florisvanvugt/taparduino/arduino/fsr_tone_disc_seq/fsr_tone_disc_seq.ino

// -*- Mode:c -*-
// The above incantation tells emacs to do C style syntax highlighting

/* Use FSR to create a sound on an audio jack from a PWM pin

Connect the audio jack to digital pin 9 through a 1kOhm resistor

Ensure that the Arduino (or microcontroller) used has a PWM pin for this arrangement.

Connect one end of FSR to 5V, the other end to Analog 0.
Then connect one end of a 10K resistor from Analog 0 to ground

*/

//////////////////////////////////// load libraries
#include <avr/pgmspace.h>
#include <avr/sleep.h>

////////////////////////////////////  set variables 
int fsrAnalogPin = 0; // FSR is connected to analog 0
int fsrReading;      // the analog reading from the FSR resistor divider
int threshold = 20; // the FSR threshold necessary to make a sound (ON)
int low_thresh = 10; // where the FSR reading must go to to be OFF
int time_thresh = 40; // set a time threshold for how long to wait until another sound can be made
int offset_thresh = 40; // set a time threshold for how long to wait after depression (prevent double taps)
unsigned long time_tol = 0; // preset the exact time from which it is ok to make another sound
unsigned long timeStamp=0; // timestamp for Arduino
unsigned long prevt=-1; // the previous time value to ensure sample rate of 1000Hz
int cur_on = 0; // say if the FSR is "on" or "off"

// variables for discrete data
unsigned long cur_onset = 0; // preset current onset time
unsigned long cur_offset = 0; // preset current offset time
int max_force = 0; // preset maximum FSR reading

// variables for tone condition
//int tone_freq = 1046.5; // defines the frequency (i.e., pitch) of the tone (in Hz)
//int tone_dur = 20; // defines the duration of the tone
unsigned long tone_tol=0; // presets the tone offset time

// variables for tone sequences
int all_tones[30] = {220, 220, 233.08, 261.63, 261.63, 233.08, 220, 196, 174.61, 174.61, 196, 220, 220, 196, 196, 220, 220, 233.08, 261.63, 261.63, 233.08, 220, 196, 174.61, 174.61, 196, 220, 196, 174.61, 174.61  };
int all_durs[30] = {200, 200, 200, 200, 200, 200, 200, 200, 200, 200, 200, 200, 400, 100, 400, 200, 200, 200, 200, 200, 200, 200, 200, 200, 200, 200, 200, 400, 100, 400  };
int all_delays[30] = {0, 0, 0, 75, 50, 50, 100, 50, 50, 50, 50, 50, 50, 25, 100, 0, 0, 0, 0, 0, 0, 0, 0, 0, 0, 0, 0, 0, 0, 0 };
int num_sounds = sizeof(all_tones)/sizeof(all_tones[0])-1;
//int all_intense[30] = { 10, 1, 5, 6, 7, 2, 3, 4, 9, 8, 7, 6, 5, 4, 3, 10, 1, 5, 6, 7, 2, 3, 4, 9, 8, 7, 6, 5, 10, 10 };
//int all_timbre[15] = { 1, 1, 1, 1, 3, 3, 3, 3, 2, 2, 2, 2, 2, 2, 2 };

// get first tone sequence value
int tone_freq = all_tones[0]; // defines the frequency (i.e., pitch) of the tone (in Hz)
int tone_dur = all_durs[0]; // defines the duration of the tone
int cur_del = all_delays[0]; // defines delays
int cur_pos = 0; // preset start position
//int intense = all_intense[0]; // defines the duration of the tone
//int cur_tim = all_timbre[1]; // defines timbre


/////////////////////////////// Set up lookup table for waveform generation
/*
A SQUARE WAVE lookup table. You can generate this using the example Python code here below:
sqwav = [ '0xff' for _ in range(256/2) ] + [ '0x00' for _ in range(256/2) ]
print ",".join(sqwav)
*/

static const uint8_t  sineTable[] PROGMEM =
{
0xff,0xff,0xff,0xff,0xff,0xff,0xff,0xff,
0xff,0xff,0xff,0xff,0xff,0xff,0xff,0xff,
0xff,0xff,0xff,0xff,0xff,0xff,0xff,0xff,
0xff,0xff,0xff,0xff,0xff,0xff,0xff,0xff,
0xff,0xff,0xff,0xff,0xff,0xff,0xff,0xff,
0xff,0xff,0xff,0xff,0xff,0xff,0xff,0xff,
0xff,0xff,0xff,0xff,0xff,0xff,0xff,0xff,
0xff,0xff,0xff,0xff,0xff,0xff,0xff,0xff,
0xff,0xff,0xff,0xff,0xff,0xff,0xff,0xff,
0xff,0xff,0xff,0xff,0xff,0xff,0xff,0xff,
0xff,0xff,0xff,0xff,0xff,0xff,0xff,0xff,
0xff,0xff,0xff,0xff,0xff,0xff,0xff,0xff,
0xff,0xff,0xff,0xff,0xff,0xff,0xff,0xff,
0xff,0xff,0xff,0xff,0xff,0xff,0xff,0xff,
0xff,0xff,0xff,0xff,0xff,0xff,0xff,0xff,
0xff,0xff,0xff,0xff,0xff,0xff,0xff,0xff,
0x00,0x00,0x00,0x00,0x00,0x00,0x00,0x00,
0x00,0x00,0x00,0x00,0x00,0x00,0x00,0x00,
0x00,0x00,0x00,0x00,0x00,0x00,0x00,0x00,
0x00,0x00,0x00,0x00,0x00,0x00,0x00,0x00,
0x00,0x00,0x00,0x00,0x00,0x00,0x00,0x00,
0x00,0x00,0x00,0x00,0x00,0x00,0x00,0x00,
0x00,0x00,0x00,0x00,0x00,0x00,0x00,0x00,
0x00,0x00,0x00,0x00,0x00,0x00,0x00,0x00,
0x00,0x00,0x00,0x00,0x00,0x00,0x00,0x00,
0x00,0x00,0x00,0x00,0x00,0x00,0x00,0x00,
0x00,0x00,0x00,0x00,0x00,0x00,0x00,0x00,
0x00,0x00,0x00,0x00,0x00,0x00,0x00,0x00,
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
0xc0, 0xc1, 0xc2, 0xc3, 0xc4, 0xc5, 0xc6, 0xc7,
0xc8, 0xc9, 0xca, 0xcb, 0xcc, 0xcd, 0xce, 0xcf,
0xd0, 0xd1, 0xd2, 0xd3, 0xd4, 0xd5, 0xd6, 0xd7,
0xd8, 0xd9, 0xda, 0xdb, 0xdc, 0xdd, 0xde, 0xdf,
0xe0, 0xe1, 0xe2, 0xe3, 0xe4, 0xe5, 0xe6, 0xe7,
0xe8, 0xe9, 0xea, 0xeb, 0xec, 0xed, 0xee, 0xef,
0xf0, 0xf1, 0xf2, 0xf3, 0xf4, 0xf5, 0xf6, 0xf7,
0xf8, 0xf9, 0xfa, 0xfb, 0xfc, 0xfd, 0xfe, 0xff
};

*/

////////////////////////////////////  set PWM variables and functions
// PWM output (OCR1A)
int pwmPin = 9;

// 16 bit accumulator
uint16_t phaseAccumulator = 0;
// 16 bit delta
uint16_t phaseIncrement = 0;
// DDS resolution
const uint32_t resolution =  68719;
// wavetable lookup index(upper 8 bits of the accumulator)
uint8_t index = 0;

// TIMER1 will overflow at a 62.5KHz(Sampling frequency).
// Updates the OCR1A value and the accumulator.
// Computes the next sample to be sent to the PWM.
ISR(TIMER1_OVF_vect)
{
  static uint8_t osc = 0;

  // Send oscillator output to PWM
  OCR1A = osc;

  // Update accumulator
  phaseAccumulator += phaseIncrement;
  index = phaseAccumulator >> 8;

  // Read oscillator value for next interrupt
  osc = pgm_read_byte( &sineTable[index] );

}

// Configures TIMER1 to fast PWM non inverted mode.
// Prescaler set to 1, which means that timer overflows
// every 16MHz/256 = 62.5KHz
void initPWM(void)
{
  // Set PORTB1 pin as output
  pinMode(pwmPin, OUTPUT);

  // 8-bit Fast PWM - non inverted PWM
  TCCR1A= _BV(COM1A1) | _BV(WGM10);

  // Start timer without prescaler
  TCCR1B = _BV(CS10) | _BV(WGM12);

  // Enable overflow interrupt for OCR1A
  TIMSK1 = _BV(TOIE1);

}

// Translates the desired output frequency to a phase
// increment to be used with the phase accumulator.
// The 16 bit shift is required to remove the  2^16
// scale factor of the resolution.
void setFrequency( uint16_t frequency )
{
  uint64_t phaseIncr64 =  resolution * frequency;
  phaseIncrement = phaseIncr64 >> 16;
}

// The duration of one metronome tick (in microsec)
const unsigned long TICKDURATION = tone_dur*1000;   // duration of ticks (legacy code)

// function to turn tick on
void tickOn(){
  setFrequency(tone_freq);
}

// function to turn sound off
void tickOff() {
  setFrequency( .05 ); // so that you practically don't hear anything (well below perceptual limit of humans)
}


//////////////////////////////////// SETUP
void setup() {
  Serial.begin(9600); // slow speed debugging
  //Serial.begin(1152000); // high speed debugging
  //Serial.begin(1555200); // good speed for processing (must match python code for reading!)
  
  // Initialise fast PWM
  initPWM();

  // Enable sleep mode
  set_sleep_mode(SLEEP_MODE_IDLE);

  // Set phase increment according to
  // desired OFF frequency
  tickOff();

  // Enable global interrupts
  sei();
 
}

//////////////////////////////////// LOOP
void loop(void) {
  getInfos(); // read info 
  
  if (fsrReading > threshold){
    cur_onset = timeStamp;
    time_tol = timeStamp+time_thresh;
    cur_on  = 1;
    
    while (timeStamp < time_tol) { // wait for delay time
      //if (fsrReading > max_force) max_force = fsrReading;
      getInfos(); // read info    
    }

    // play the tone
    tickOn(); // change PWM output to tone frequency
    tone_tol = timeStamp+tone_dur; // set tone off time        
    getInfos(); // read info
    
    // now let's stop it from playing again until after the time threshold and the FSR reading returns to zero    
    while (fsrReading > low_thresh) {
      getInfos(); // read info
    }
    
    cur_offset = timeStamp; // get offset time   
    collectData(); // send data   
    time_tol = timeStamp+offset_thresh; // set time until next tap can occur
    
    // now let's stop it from playing again until after the time threshold and the FSR reading returns to zero    
    while ((timeStamp < time_tol) || (fsrReading > low_thresh)) {      
      getInfos(); // read info      
   }
   
   // reset our variables
   if (cur_pos == num_sounds) {
     cur_pos = 0; 
   }
   else {
     cur_pos = cur_pos+1;      
   }
    
   tone_freq = all_tones[cur_pos]; // defines the frequency (i.e., pitch) of the tone (in Hz)
   tone_dur = all_durs[cur_pos]; // defines the duration of the tone
   cur_del = all_delays[cur_pos]; // defines delays
   
  }
  
  max_force = fsrReading;
     
}

//////////////////////////////////// FUNCTIONS
// Send data to serial port
void collectData() { 
      
  if (prevt==-1 | timeStamp!=prevt) { 
    // only send if the time has changed, that is, 
    // force the data transfer to maximum of 1000Hz.
    // Using higher sample rates can result in buffer
    // overflows and missed packets

    // Send data to the serial port (for degugging in Arduino serial manager)
    //Serial.print("Onset time = ");
    //Serial.print(cur_onset);
    //Serial.print(" Offset time = ");
    //Serial.print(cur_offset);
    //Serial.print(" Maximum force = ");
    //Serial.print(max_force);    
    //Serial.print("\n");
    
    // Send data to the serial port
    Serial.print("B"); // signal packet start (hardcoded)
    sendBinary(cur_onset); // send onset time
    sendBinary(cur_offset); // send offset time
    sendBinary(max_force); // send max FSR reading
    Serial.print("E"); // signal packet end (hardcoded)
    prevt=timeStamp; // send previous time marker
  }    
}

// get FSR and timing info, and turn off the sound at end of tone duration
void getInfos() {
  fsrReading = analogRead(fsrAnalogPin); // read FSR
  timeStamp = millis(); // get time (in milliseconds)       
  if (timeStamp>=tone_tol) {
    tickOff(); // turn sound off
    phaseAccumulator = 0; // reset phase
  }
  if (fsrReading > max_force) max_force = fsrReading;
  if ((cur_on==1) && (fsrReading <= low_thresh)) {
    cur_offset = timeStamp; // get offset time   
    collectData(); // send data   
    cur_on = 0;
  }  
}

// Send data in binary to increase speed and reduce buffer overflow
void sendBinary(int value) 
// Send a binary value directly (without conversion to string)
// based on http://my.safaribooksonline.com/book/hobbies/9781449399368/serial-communications/sending_binary_data_from_arduino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
{
  Serial.write(lowByte(value));
  Serial.write(highByte(value));
}
