florisvanvugt/taparduino/gui/capture-gui.py

#
#
#
# This is a graphical user interface that is used to conveniently capture data from arduino, 
# through USB, to a PC or Mac computer, and dump it to a text file for future analysis.
#
#
#
#





import threading

import os.path 


import Tkinter 
import tkFileDialog
from Tkinter import *
from tkFileDialog import asksaveasfilename

import tkMessageBox


from FileDialog import LoadFileDialog, SaveFileDialog

import platform
import os


import sys

try:
    import serial
except:
    msg = "An error occurred while importing the pySerial module.\n\nGo to https://pypi.python.org/pypi/pyserial to install the module,\nor refer to our manual for help.\n\nThe program will now quit."
    print msg
    tkMessageBox.showinfo("Error importing pySerial", msg)
    sys.exit(-1)


import time
baudrate_discrete   = 9600    # for the discrete data setting (load the corresponding Arduino script)
baudrate_continuous = 115200  # for the continuous data setting (load the corresponding Arduino script)






## The maximum number of lines to remain in the GUI text area
## (this prevents errors due to keeping all lines in memory)
MAX_LINES = 42



class Reporter:

    # This class will receive the data and display it in the text field in the GUI.

    def __init__(self):
        self.thread = None
        self.lock = False
    
    def report(self,message):
        if not self.lock:
            self.lock = True
            #print "Reporting",message
            self.text.insert(Tkinter.END,message)

            #numlines = int(self.text.index('end - 1 line').split('.')[0])
            #numlines = int(self.text.index('end').split('.')[0]) - 1
            numlines = self.text.get("1.0", Tkinter.END).count("\n")
            #print numlines
            #log['state'] = 'normal'
            if numlines>MAX_LINES:
                #print "Number of lines: %i"%numlines
                #self.text.delete(1.0, "%i.0"%(MAX_LINES-numlines+1))
                self.text.delete("1.0", "2.0")

            self.text.see(Tkinter.END)
            self.lock= False

    def settextreceiver(self,textreceiver):
        self.text = textreceiver

    def startNew(self):
        # Clear the text field
        self.text.delete(1.0, END)

    def updateButtons(self):
        # This enables/disables buttons depending on whether we are running a capture at the moment or not
        if keepGoingB.get():
            #self.previewB.configure(state=NORMAL,background="yellow")
            self.stopB.configure   (state=NORMAL,  background="red")
            self.captureB.configure(state=DISABLED,background="gray")

            self.discR.config(state=DISABLED)
            self.contR.config(state=DISABLED)

        else:

            self.discR.config(state=NORMAL)
            self.contR.config(state=NORMAL)

            # Update which buttons are enabled or not
            global packetI

            continuous = packetI.get()!=1
            if continuous:
                buttonstate = NORMAL
            else:
                buttonstate = DISABLED
            # Whether we are in continuous data mode

            self.fastR.config(  state=buttonstate)
            self.mediumR.config(state=buttonstate)
            self.slowR.config(  state=buttonstate)

            self.stopB.configure   (state=DISABLED,background="gray")
            if len(fileS.get())>0:
                self.captureB.configure(state=NORMAL,  background="darkgreen")
            else:
                reporter.captureB.configure( state=DISABLED, background="gray" )






    def determine_dump_interval(self):
        global packetI # tells us what kind of data package we expect
        global displayI # tells us what kind of display refresh rate

        packet_type = packetI.get()
        if packet_type==1:
            # discrete: one packet per tap
            self.report_dump_interval = 1
        if packet_type==2:
            
            refreshrate = displayI.get()
            
            # This controls what fraction of packages is displayed: if set to 100, it will show 1 package in 100.
            refreshrates = {1: 10,
                            2: 100,
                            3: 1000}
            self.report_dump_interval = refreshrates[refreshrate]
            







def interpret_output_discrete(r):
    # Interpret the raw (binary) output that we got from Arduino.

    #Packet
    #|---------+---+---------+----------+-------------+---|
    #| Byte    | 1 | 2,3     | 4,5      | 6,7         | 8 |
    #| Content | B | [onset] | [offset] | [max force] | E |
    #|---------+---+---------+----------+-------------+---|
    
    #Where [t] = N for oNset, F for oFfset
    #and [time] is the timestamp (in msec)


    # Here we interpret the packet that we received from Arduino.
    # Note that the first element of the packet (B in our case) has been omitted here.
    tap_onset  = ord(r[0])+256*ord(r[1])
    tap_offset = ord(r[2])+256*ord(r[3])
    maxforce   = ord(r[4])+256*ord(r[5])
    
    # Make a formatted output
    output = "%i %i %i"%(tap_onset,tap_offset,maxforce)

    return output



def interpret_output_continuous(r):
    # Interpret the raw (binary) output that we got from Arduino.

    # Packet
    #|---------+---+-------------+---------------+---|
    #| Byte    | 1 | 2,3         | 4,5           | 6 |
    #| Content | B | [timestamp] | [fsr-reading] | E |
    #|---------+---+-------------+---------------+---|
    #Here [timestamp] is the timestamp (in msec)
    #and [fsr-reading] is the FSR voltage (in arduino's arbitrary units).


    # Here we interpret the packet that we received from Arduino.
    # Note that the first element of the packet (B in our case) has been omitted here.
    timestamp   = ord(r[0])+256*ord(r[1])
    fsr_reading = ord(r[2])+256*ord(r[3])
    
    # Make a formatted output
    output = "%i %i"%(timestamp,fsr_reading)

    return output












def askSaveFile():
    # Asks where to save the file

    global fileS
    global reporter

    filename = asksaveasfilename(parent=root,
                                 defaultextension=".txt",
                                 initialfile=fileS.get(),
                                 filetypes=[("text files","*.txt"),
                                            ("all files","*")])

    if filename:
        fileS.set(filename)
        reporter.updateButtons()
        


def stopCapture():
    global keepGoingB
    global reporter

    keepGoingB.set(False)
    reporter.report("Capture stopped.\n\n")
    reporter.thread=None
    reporter.updateButtons()

    reporter.comm.close()



def runCapture():

    # This is called from the doCapture function

    print ("Starting capture")
        
    # Start up the serial communication
    commport = usbS.get()
    packet_type = packetI.get()
    if (packet_type==1):
        baudrate = baudrate_discrete
    else:
        baudrate = baudrate_continuous

    try:
        comm = serial.Serial(commport, baudrate, timeout=0.25)
    except:
        reporter.report("Cannot open USB port %s. Is the device connected?\n"%commport)
        stopCapture()
        return -1

    reporter.comm = comm

    filename = fileS.get() # get the filename we are supposed to output to

    if len(filename)==0:
        reporter.report("Please select an output file.\n")
        stopCapture()
        return -1

       
    if os.path.isfile(filename):
        reporter.report("Output file previously existed! If we continue, we will overwrite all data in it.\n")
        if not tkMessageBox.askyesno('Confirm overwriting data file', 'The data file you have selected for output already exists.\nIf we proceed, all data currently in the file will be erased.\n\nAre you sure that you want to continue?'):
            reporter.report("Capture aborted because the user does not want to overwrite the data file.\n")
            stopCapture()
            return -1
        

    dumpfile = open(filename,'w')

    do_continue=True
    keepGoingB.set(do_continue)
    reporter.report("Starting capture (%s)\n"%filename)
    reporter.updateButtons()


    reporter.report("")
    reporter.report(output_header+"\n")
    dumpfile.write(output_header+"\n")

    i=0
    while do_continue:

        # Ok, let's read one byte
        r = comm.read(1)

        if r=="B": # This could be the beginning of a packet from arduino

            avail=0 # how many bytes are available
            while avail<PACKET_LENGTH-1: # read to fill up the packet
                avail=comm.inWaiting()

            # all right, now we can read
            r = comm.read(PACKET_LENGTH-1) # read the whole packet straight away

            # Now continue to work with this
            if len(r)==(PACKET_LENGTH-1) and r[-1]=="E": # if we have the correct ending also

                output = interpret_output(r)
                dumpfile.write(output+"\n")
                dumpfile.flush()

                # Occasionally give a bleep so the user knows
                # we're still working
                i+=1
                if i>=reporter.report_dump_interval:
                    reporter.report(output+"\n")
                    i=0

            else:
                if len(r)>0:
                    reporter.report("rejected")

        do_continue = keepGoingB.get()


    # Update which button is enabled etc.
    reporter.updateButtons()






def doCapture():

    # This is when the "capture" button is pressed
    # First, we set everything up and then we set the actual capture in motion

    global reporter

    if reporter.thread!=None:
        reporter.report("Already running!\n")
        return -1


    # The expected packet length

    global PACKET_LENGTH
    global interpret_output
    global output_header
    packet_type = packetI.get()
    if packet_type==1:
        # discrete: one packet per tap
        PACKET_LENGTH = 8
        interpret_output = interpret_output_discrete
        output_header = "onset offset maxforce"


    if packet_type==2:
        # continuous: simply forwarding the trace of the FSR sensor
        PACKET_LENGTH = 6
        interpret_output = interpret_output_continuous
        output_header = "timestamp force_reading"



    reporter.startNew()
    reporter.determine_dump_interval()
    reporter.thread = threading.Thread(target=runCapture)
    reporter.thread.start()



    







def build_gui():


    # Making a bunch of variables that I will access from anywhere in this GUI
    global usbS       # the current setting for the serial port
    global fileS      # the current setting for the file name
    global packetI    # the type of data that we will receive from arduino
    global displayI   # how often the display should update
    global keepGoingB # keep track of whether we're still capturing
    global root

    root =Tk()
    root.title('Tap-Arduino Capture GUI (Ben Schultz & Floris van Vugt)')

    usbS       = StringVar()
    fileS      = StringVar()
    packetI    = IntVar()
    displayI   = IntVar()
    keepGoingB = BooleanVar()

    packetI.set(1)
    displayI.set(2)

    if len(sys.argv)>1:
        usbS.set(sys.argv[1])
    else:
        if platform.system()=="Windows":
            usbS.set("COM<NUMBER>")
        elif os.name=="posix":
            usbS.set("/dev/ttyACM0")
        else:
            usbS.set("<ENTER SERIAL PORT HERE>")
    if len(sys.argv)>2:
        fileS.set(sys.argv[2])
    else:
        fileS.set("")
    keepGoingB.set(False)


    global reporter
    reporter = Reporter()


    usbF = Frame(root)
    Label (usbF,text='serial port').pack(side=LEFT,padx=10,pady=10)
    usbEntry = Entry (usbF,width=30,textvariable=usbS)
    #usbEntry = Frame (usbF,background="red")
    usbEntry.pack(expand=True,side=LEFT,padx=10,pady=10,fill=BOTH)
    #Label (usbEntry,text="this will expand?").pack(side=LEFT,padx=10,pady=10,fill=BOTH)
    #usbEntry.pack(side=LEFT,padx=10,pady=10,fill=BOTH)
    usbF.pack(side=TOP,padx=10,fill=X)



    fileF = Frame(root)
    Label (fileF,text='save to file').pack(side=LEFT,padx=10)
    fileEntry = Entry (fileF,width=30,textvariable=fileS)
    fileEntry.pack(side=LEFT,expand=True,padx=10,pady=10,fill=X)
    fileB = Button(fileF,text="select",command=askSaveFile)
    fileB.pack(side=RIGHT,padx=10,pady=10)
    fileF.pack(padx=10,pady=0,fill=X)
    



    packetF = Frame(root)
    Label (packetF,text='data type').pack(side=LEFT,padx=10)
    discR = Radiobutton(packetF, text="discrete",   variable=packetI, value=1, command=reporter.updateButtons)
    contR = Radiobutton(packetF, text="continuous", variable=packetI, value=2, command=reporter.updateButtons)
    discR.pack(side=LEFT,padx=10,pady=10)
    contR.pack(side=LEFT,padx=10,pady=10)
    packetF.pack(padx=10,pady=0,fill=X)




    updateF = Frame(root)
    Label (updateF,text='display update').pack(side=LEFT,padx=10)
    fastR    = Radiobutton(updateF, text="fast",   variable=displayI, value=1, command=reporter.determine_dump_interval)
    mediumR  = Radiobutton(updateF, text="medium", variable=displayI, value=2, command=reporter.determine_dump_interval)
    slowR    = Radiobutton(updateF, text="slow",   variable=displayI, value=3, command=reporter.determine_dump_interval)
    fastR.pack(side=LEFT,padx=10,pady=10)
    mediumR.pack(side=LEFT,padx=10,pady=10)
    slowR.pack(side=LEFT,padx=10,pady=10)
    updateF.pack(padx=10,pady=0,fill=X)





    reportF = Frame(root)
    s       = Scrollbar(reportF)
    reportT = Text(reportF,height=8,width=8)
    reporter.settextreceiver(reportT)
    reportT.pack(side=LEFT, padx=5, pady=5,fill=BOTH,expand=True)
    s.pack(side=RIGHT,fill=Y)
    s.config(command=reportT.yview)
    reportT.config(yscrollcommand=s.set)               
    reportF.pack(side=TOP,fill=BOTH,expand=True)

    #for i in range(80): 
    #   reportT.insert(END, "This is line %d\n" % i)


    buttonF = Frame(root)
    captureB = Button(buttonF, text='capture', command=doCapture, background="darkgreen" )
    captureB.configure(state=DISABLED,background="darkgray")
    captureB.pack(side=LEFT,padx=10,pady=10)
    stopB = Button(buttonF, text='stop', command=stopCapture, background="red" )
    stopB.pack(side=LEFT,padx=10,pady=10)
    buttonF.pack(side=BOTTOM,padx=10,pady=10)
    stopB.configure(state=DISABLED,background="darkgray")


    def refresh_buttons(*args):
        #print "Updating GUI"
        reporter.updateButtons()

    fileS.trace('w',refresh_buttons)
    #fileEntry.bind("<KeyPress>",refresh_buttons)



    reporter.stopB    = stopB
    reporter.captureB = captureB
    reporter.fastR    = fastR
    reporter.mediumR  = mediumR
    reporter.slowR    = slowR
    reporter.discR    = discR
    reporter.contR    = contR
    reporter.updateButtons()

    root.geometry("600x700")

    root.mainloop()






build_gui()
