florisvanvugt/taparduino/(commit log)

2015-03-05 Adding the basic Arduino codes and the interface.
2015-03-09 Sending a more user-friendly error message when pyserial is not installed.
    [capture-gui.py]
2015-03-09 Corrected module name of pyserial.
    [capture-gui.py]
2015-04-15 Adding update rate buttons to the GUI.
2015-05-07 Deleting lines from the GUI text area to prevent a crash when it fills up.
    [capture-gui.py]
2015-05-07 Fixing a bug in the running text area.
    [capture-gui.py]
2015-05-07 Now the green capture button becomes enabled when you enter text in the file widget (i.e. without clicking on the corresponding button).
